surhendhaar07/IV_Drips_Moinitor_Dashboard/public/hospital_backdrop.jpg

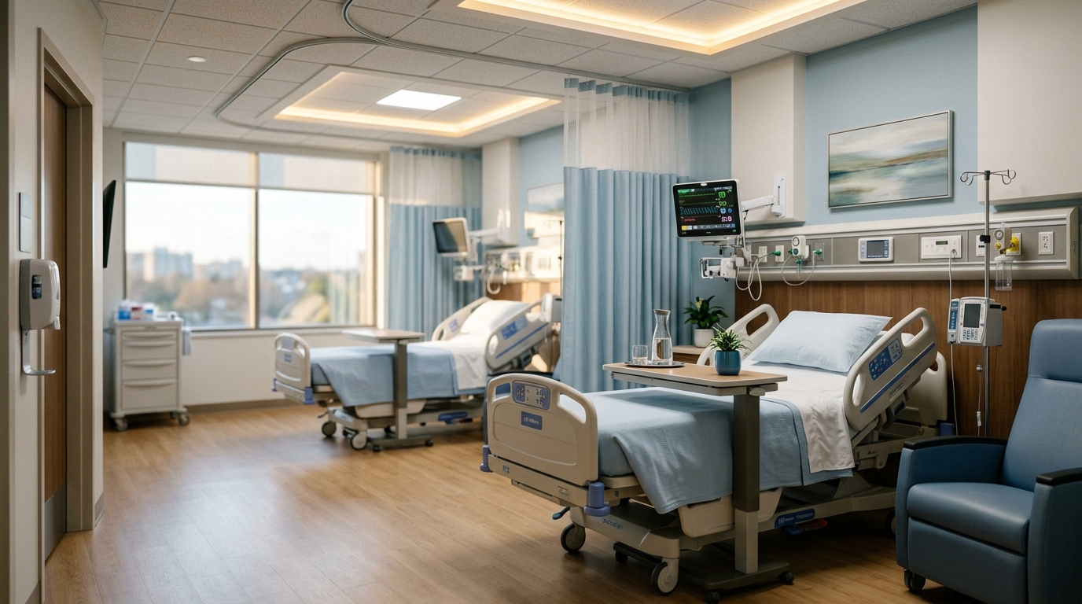
public/hospital_backdrop.jpg
