surhendhaar07/IV_Drips_Moinitor_Dashboard/CAD Designs/Servo arm.stl

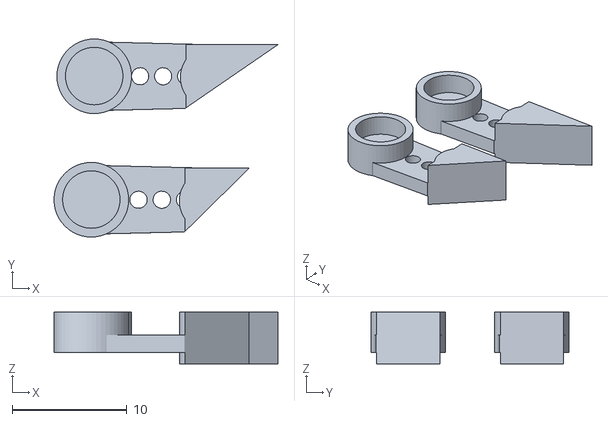
[picture p2: CAD file, 2026-10-25]
CAD Designs/Servo arm.stl
19.5 x 17.2 x 4.50
