surhendhaar07/IV_Drips_Moinitor_Dashboard/CAD Designs/ESP Cover bottom.stl

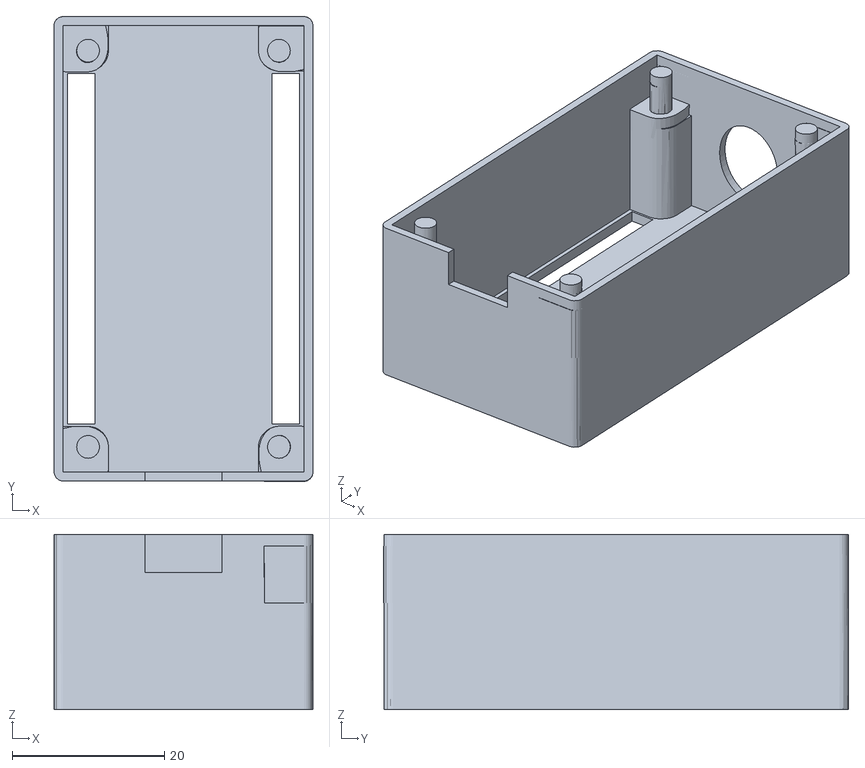
[picture p3: CAD file, 2026-10-25]
CAD Designs/ESP Cover bottom.stl
34.0 x 61.0 x 23.0
