surhendhaar07/IV_Drips_Moinitor_Dashboard/CAD Designs/Servo Enclosure TOP.stl

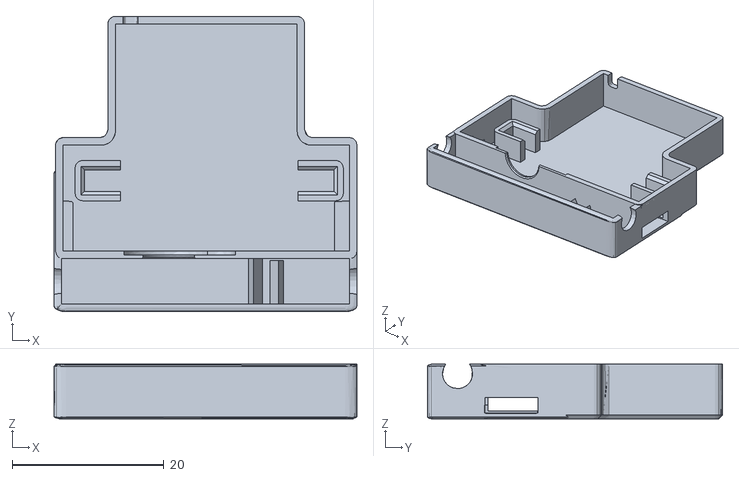
[picture p4: CAD file, 2026-10-25]
CAD Designs/Servo Enclosure TOP.stl
40.0 x 39.0 x 7.25
