surhendhaar07/IV_Drips_Moinitor_Dashboard/CAD Designs/Servo Enclosure BOTTOM.stl

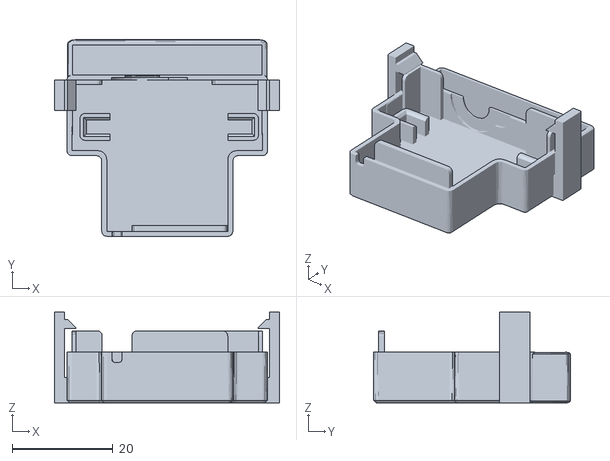
[picture p5: CAD file, 2026-10-25]
CAD Designs/Servo Enclosure BOTTOM.stl
44.6 x 39.0 x 18.0
