surhendhaar07/IV_Drips_Moinitor_Dashboard/CAD Designs/Liquid Sensor Holder.stl

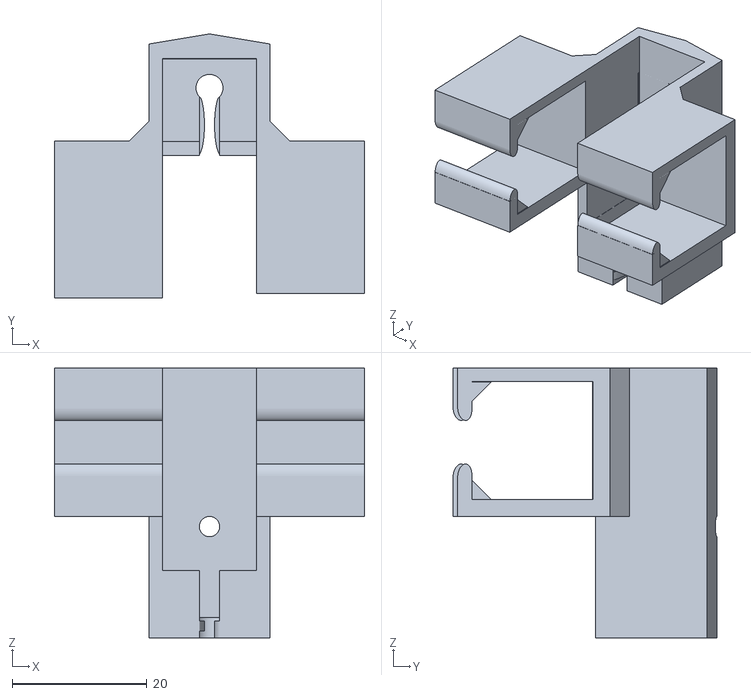
[picture p6: CAD file, 2026-10-25]
CAD Designs/Liquid Sensor Holder.stl
46.0 x 39.2 x 40.0
