surhendhaar07/IV_Drips_Moinitor_Dashboard/CAD Designs/Clamp.stl

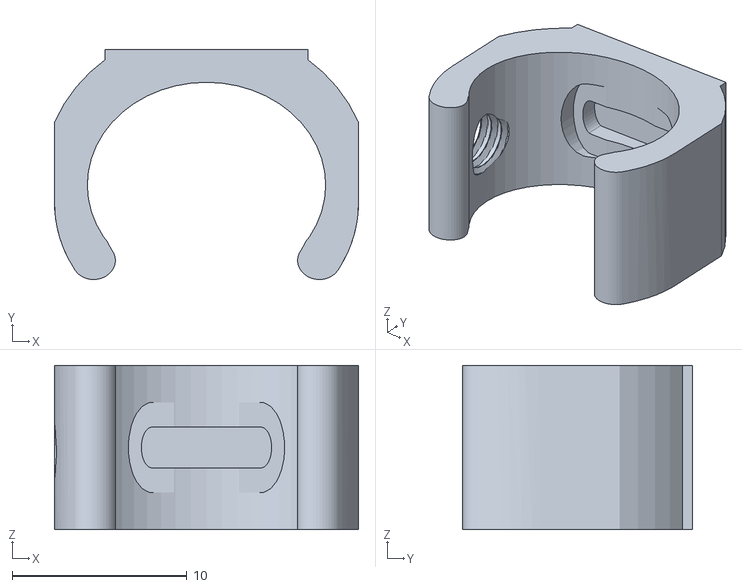
[picture p7: CAD file, 2026-10-25]
CAD Designs/Clamp.stl
17.4 x 13.2 x 9.40
