surhendhaar07/IV_Drips_Moinitor_Dashboard/CAD Designs/Enclosure Box.stl

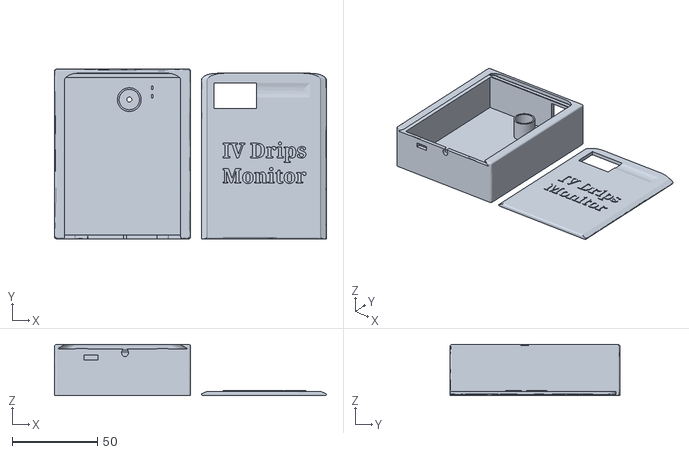
[picture p8: CAD file, 2026-10-25]
CAD Designs/Enclosure Box.stl
160.0 x 100.0 x 30.0
