surhendhaar07/IV_Drips_Moinitor_Dashboard/CAD Designs/ESP Cover top.stl

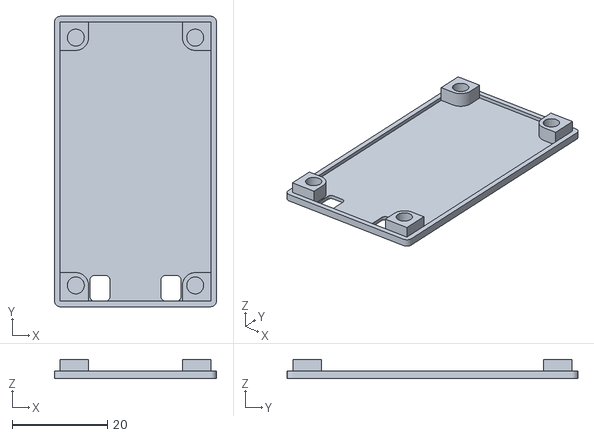
[picture p9: CAD file, 2026-10-25]
CAD Designs/ESP Cover top.stl
34.0 x 61.0 x 4.00
