surhendhaar07/IV_Drips_Moinitor_Dashboard/CAD Designs/Clamp Screw.stl

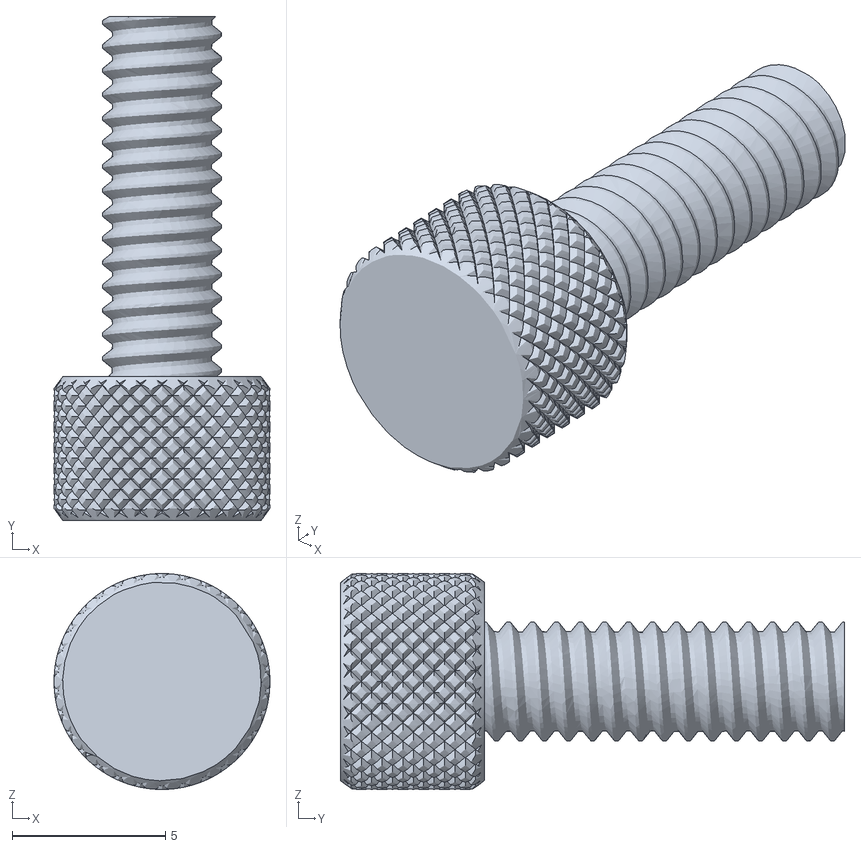
[picture p10: CAD file, 2026-10-25]
CAD Designs/Clamp Screw.stl
7.05 x 16.5 x 7.05
