surhendhaar07/IV_Drips_Moinitor_Dashboard/(commit log)

2026-10-23 docs: update README with Vishwakarma Awards submission details, system flowchart, and BOM specifications
2026-10-23 docs: update prototype cost badge to 1620 to 2000 Rs in README header
2026-10-25 feat: add CAD designs 3D printable STL models
    [Clamp Screw.stl, Clamp.stl, ESP Cover bottom.stl, ESP Cover top.stl, Enclosure Box.stl, Liquid Sensor Holder.stl, Servo Enclosure BOTTOM.stl, Servo Enclosure TOP.stl]
2026-10-25 docs: update Bill of Materials and prototype cost to final ₹1,950 specification
2026-10-26 feat: add standalone doctor live simulation with autonomous devices and low fluid alerts
2026-10-26 style: position Doctor Live Simulation demo button prominently above username input with hero styling
2026-10-26 feat: implement immediate auto-clamp upon fluid empty and anti-WDT stability in ESP8266 and web app
    [IV_Drips_Monitor_ESP8266.ino]
2026-10-26 fix: alert buzzer even when servo is clamped and add zero-delay event sync to Firebase
    [IV_Drips_Monitor_ESP8266.ino]
2026-10-26 fix: resolve ESP8266 BearSSL buffer heap exhaustion and servo brownout crash loop
    [IV_Drips_Monitor_ESP8266.ino]
2026-10-26 fix(esp8266): implement hardware timer interrupt (Ticker) for steady rhythmic buzzer with constant gap and sensor debouncing
    [IV_Drips_Monitor_ESP8266.ino]
